McMaster-Rocketry-Team/OZYS_V3/firmware/README.md

# OZYS V3 Firmware

There is no bootloader. The firmware links at the reset vector and is flashed
directly, so nothing needs to be on the board beforehand.

## Memory Layout

The memory layout is defined in `memory.x`.

- Flash: 480KiB used of 512KiB, from `0x08000000`
- RAM: 128KiB

## Notes

- Flash firmware: `cargo run`
- Check firmware size: `python size.py`

`dev` profile and `release` profile are the same, so its fine to use the run button for final production firmware.

## rocket-cli

`rocket-cli` is a tool that simplifies uploading code and monitoring logs. Install it globally to the system by first cd into `<path-to-rust-monorepo>/rocket-cli` then run `cargo install --profile rocket-cli --path . --locked`

`rocket-cli` uses ST-Link or bluetooth for uploading depending on if an ST-Link is connected.

## Troubleshooting

If you think your code should run but the stm does not start or stops in the middle of execution:

1. Switch back from `rocket-cli` to `probe-rs` in `.cargo/config.toml`
2. Do not connect to ST-Link, instead use an external power
3. Power cycle the stm
