McMaster-Rocketry-Team/OZYS_V3/ozyz_v3/Graphics/bnw-text.png

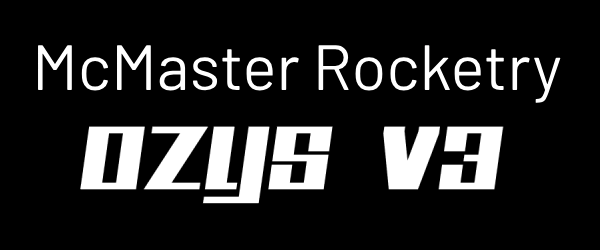
ozyz_v3/Graphics/bnw-text.png
