McMaster-Rocketry-Team/OZYS_V3/ozyz_v3/Graphics/BNW.png

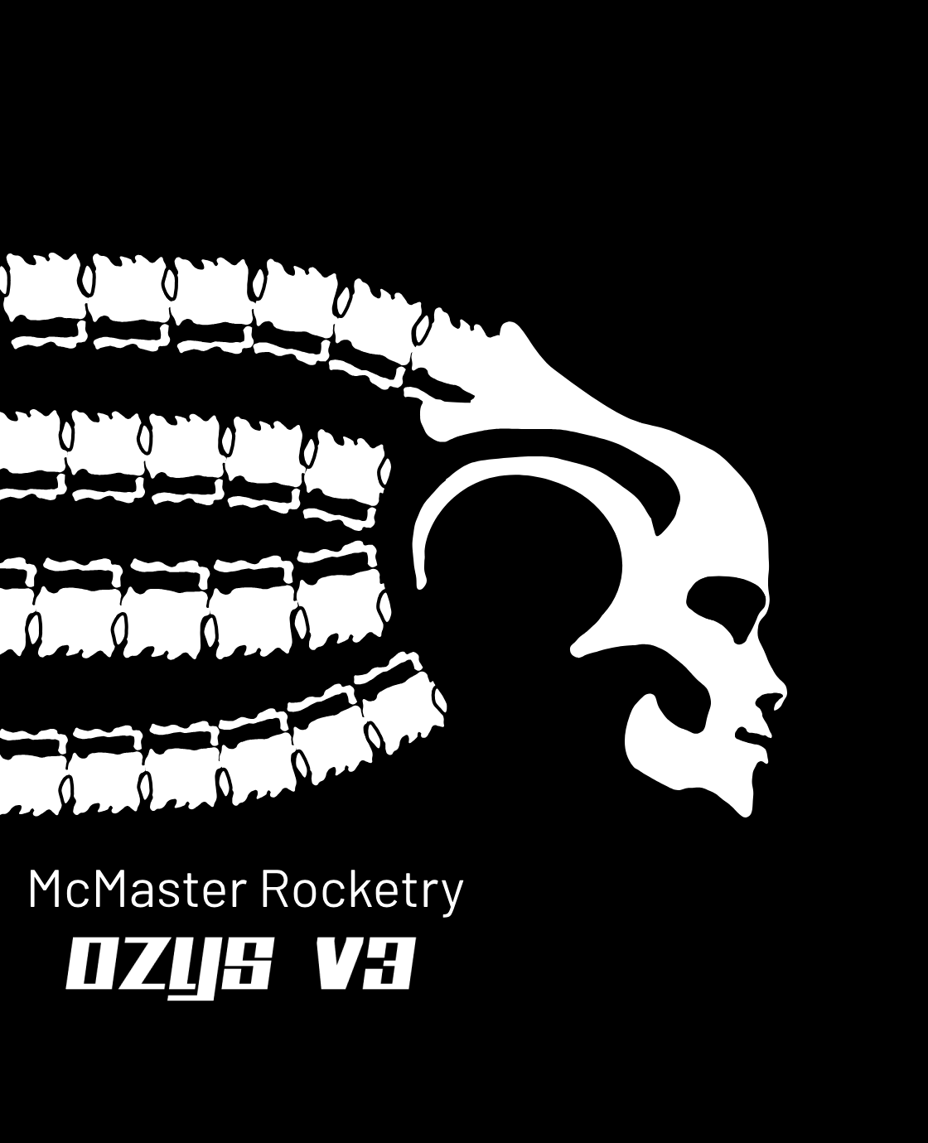
ozyz_v3/Graphics/BNW.png
