McMaster-Rocketry-Team/OZYS_V3/epsilon_r1/Epsilon_final.kicad_pcb

## KiCad design epsilon_r1/Epsilon_final.kicad_pcb (2025-02-16)

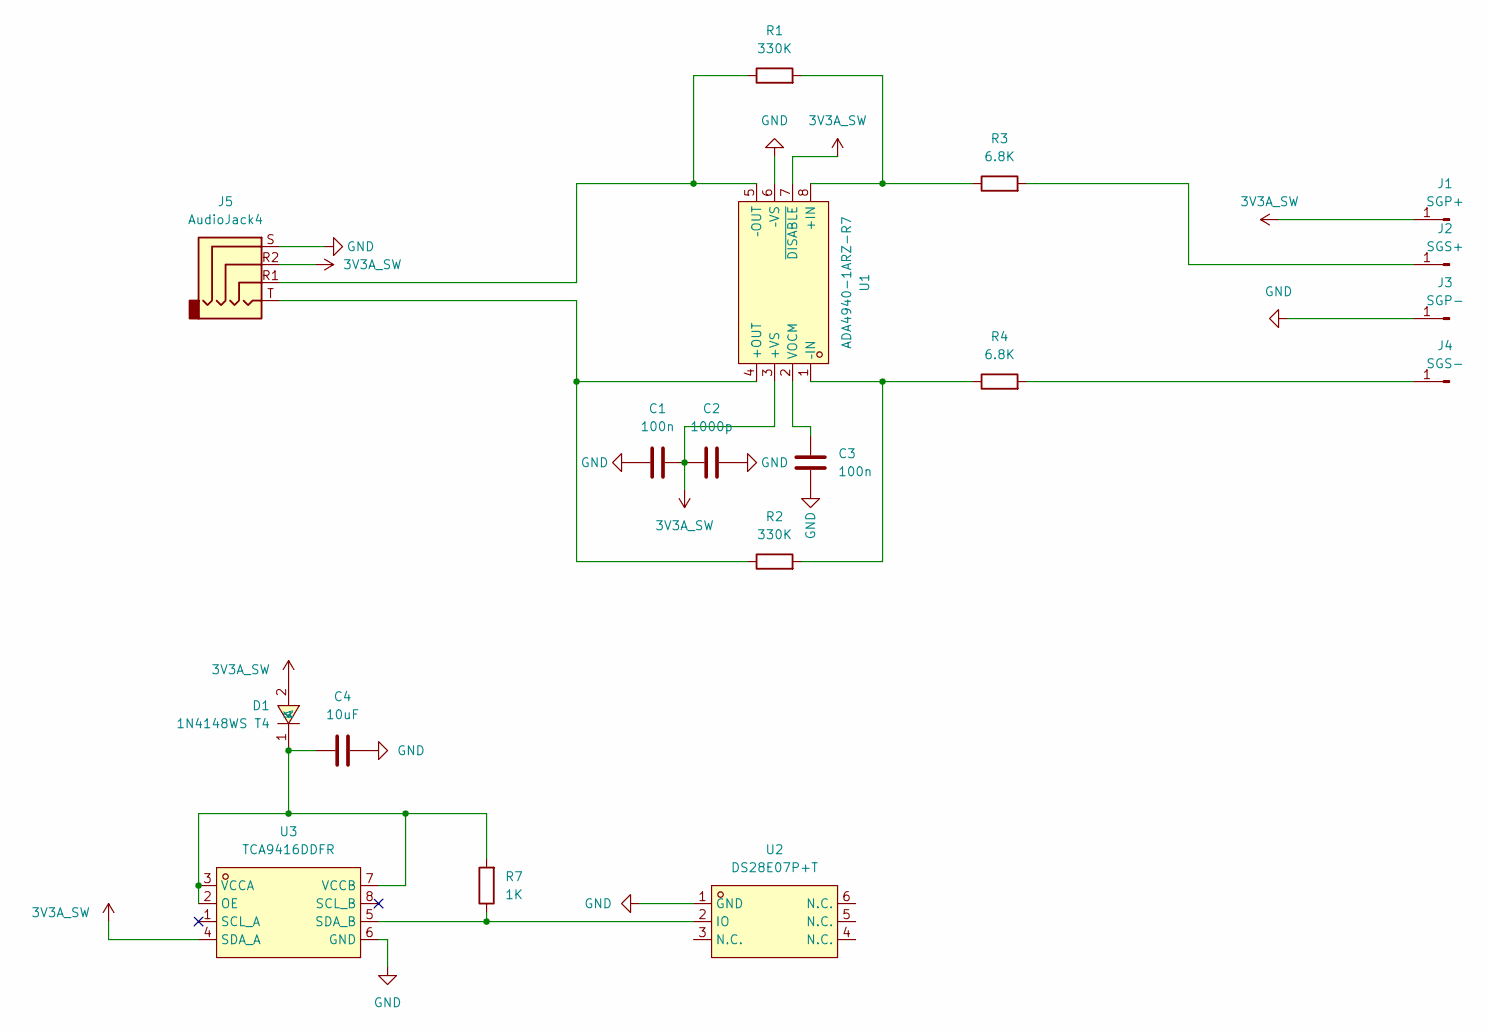
[picture p5: schematic Epsilon_final.kicad_sch]

Parts:
C1, C3: 100n; C_0402_1005Metric
C2: 1000p; C_0402_1005Metric
C4: 10uF; C_0402_1005Metric
D1: 1N4148WS T4; SOD-323_L1.8-W1.3-LS2.5-RD; LCSC Part C2128
J1: SGP+; SolderWirePad_1x01_SMD_1x2mm
J2: SGS+; SolderWirePad_1x01_SMD_1x2mm
J3: SGP-; SolderWirePad_1x01_SMD_1x2mm
J4: SGS-; SolderWirePad_1x01_SMD_1x2mm
J5: AudioJack4; AUDIO-TH_PJ-320A-4P-DIP
R1, R2: 330K; R_0603_1608Metric_Pad0.98x0.95mm_HandSolder
R3, R4: 6.8K; R_0603_1608Metric_Pad0.98x0.95mm_HandSolder
R7: 1K; R_0402_1005Metric
U1: ADA4940-1ARZ-R7; LFCSP-16_L3.0-W3.0-P0.50-BL-EP1.3; LCSC Part C730049
U2: DS28E07P+T; TSOC-6_L3.9-W4.3-P1.27-BL; LCSC Part C2063921
U3: TCA9416DDFR; TSOT-23-8_L2.9-W1.6-P0.65-LS2.8-BR; LCSC Part C4364143

Connections:
3V3A_SW: C1.1, C2.2, D1.2 (A), J1.1, J5.R2, U1.3 (+VS), U1.7 (~DISABLE), U3.4 (SDA_A)
GND: C1.2, C2.1, C3.1, C4.2, J3.1, J5.S, U1.6 (–VS), U2.1 (GND), U3.6 (GND)
unnamed: C4.1, D1.1 (K), R7.2, U3.2 (OE), U3.3 (VCCA), U3.7 (VCCB)
unnamed: J2.1, R3.2
unnamed: J4.1, R4.2
unnamed: R1.2, R3.1, U1.8 (+IN)
unnamed: J5.T, R2.1, U1.4 (+OUT)
unnamed: C3.2, U1.2 (VOCM)
unnamed: R2.2, R4.1, U1.1 (–IN)
unnamed: J5.R1, R1.1, U1.5 (–OUT)
unnamed: R7.1, U2.2 (IO), U3.5 (SDA_B)

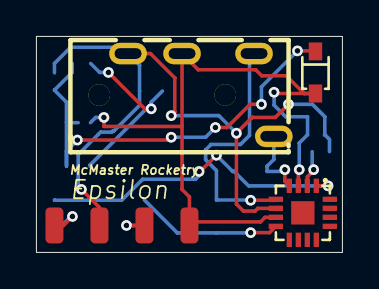
[picture p6: board Epsilon_final.kicad_pcb from above]

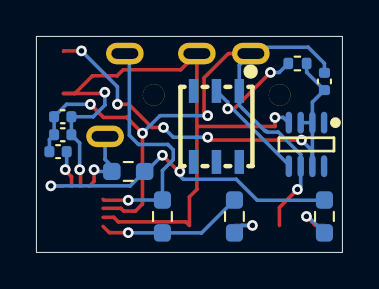
[picture p7: board Epsilon_final.kicad_pcb from below]

Board: 2 copper layers, 17.0 x 12.0 mm, 18 parts (11 on the bottom side), 11 nets.
