McMaster-Rocketry-Team/OZYS_V3/ozyz_v3/OZYS_V3_Final.kicad_pcb

## KiCad design ozyz_v3/OZYS_V3_Final.kicad_pcb (2025-03-06)

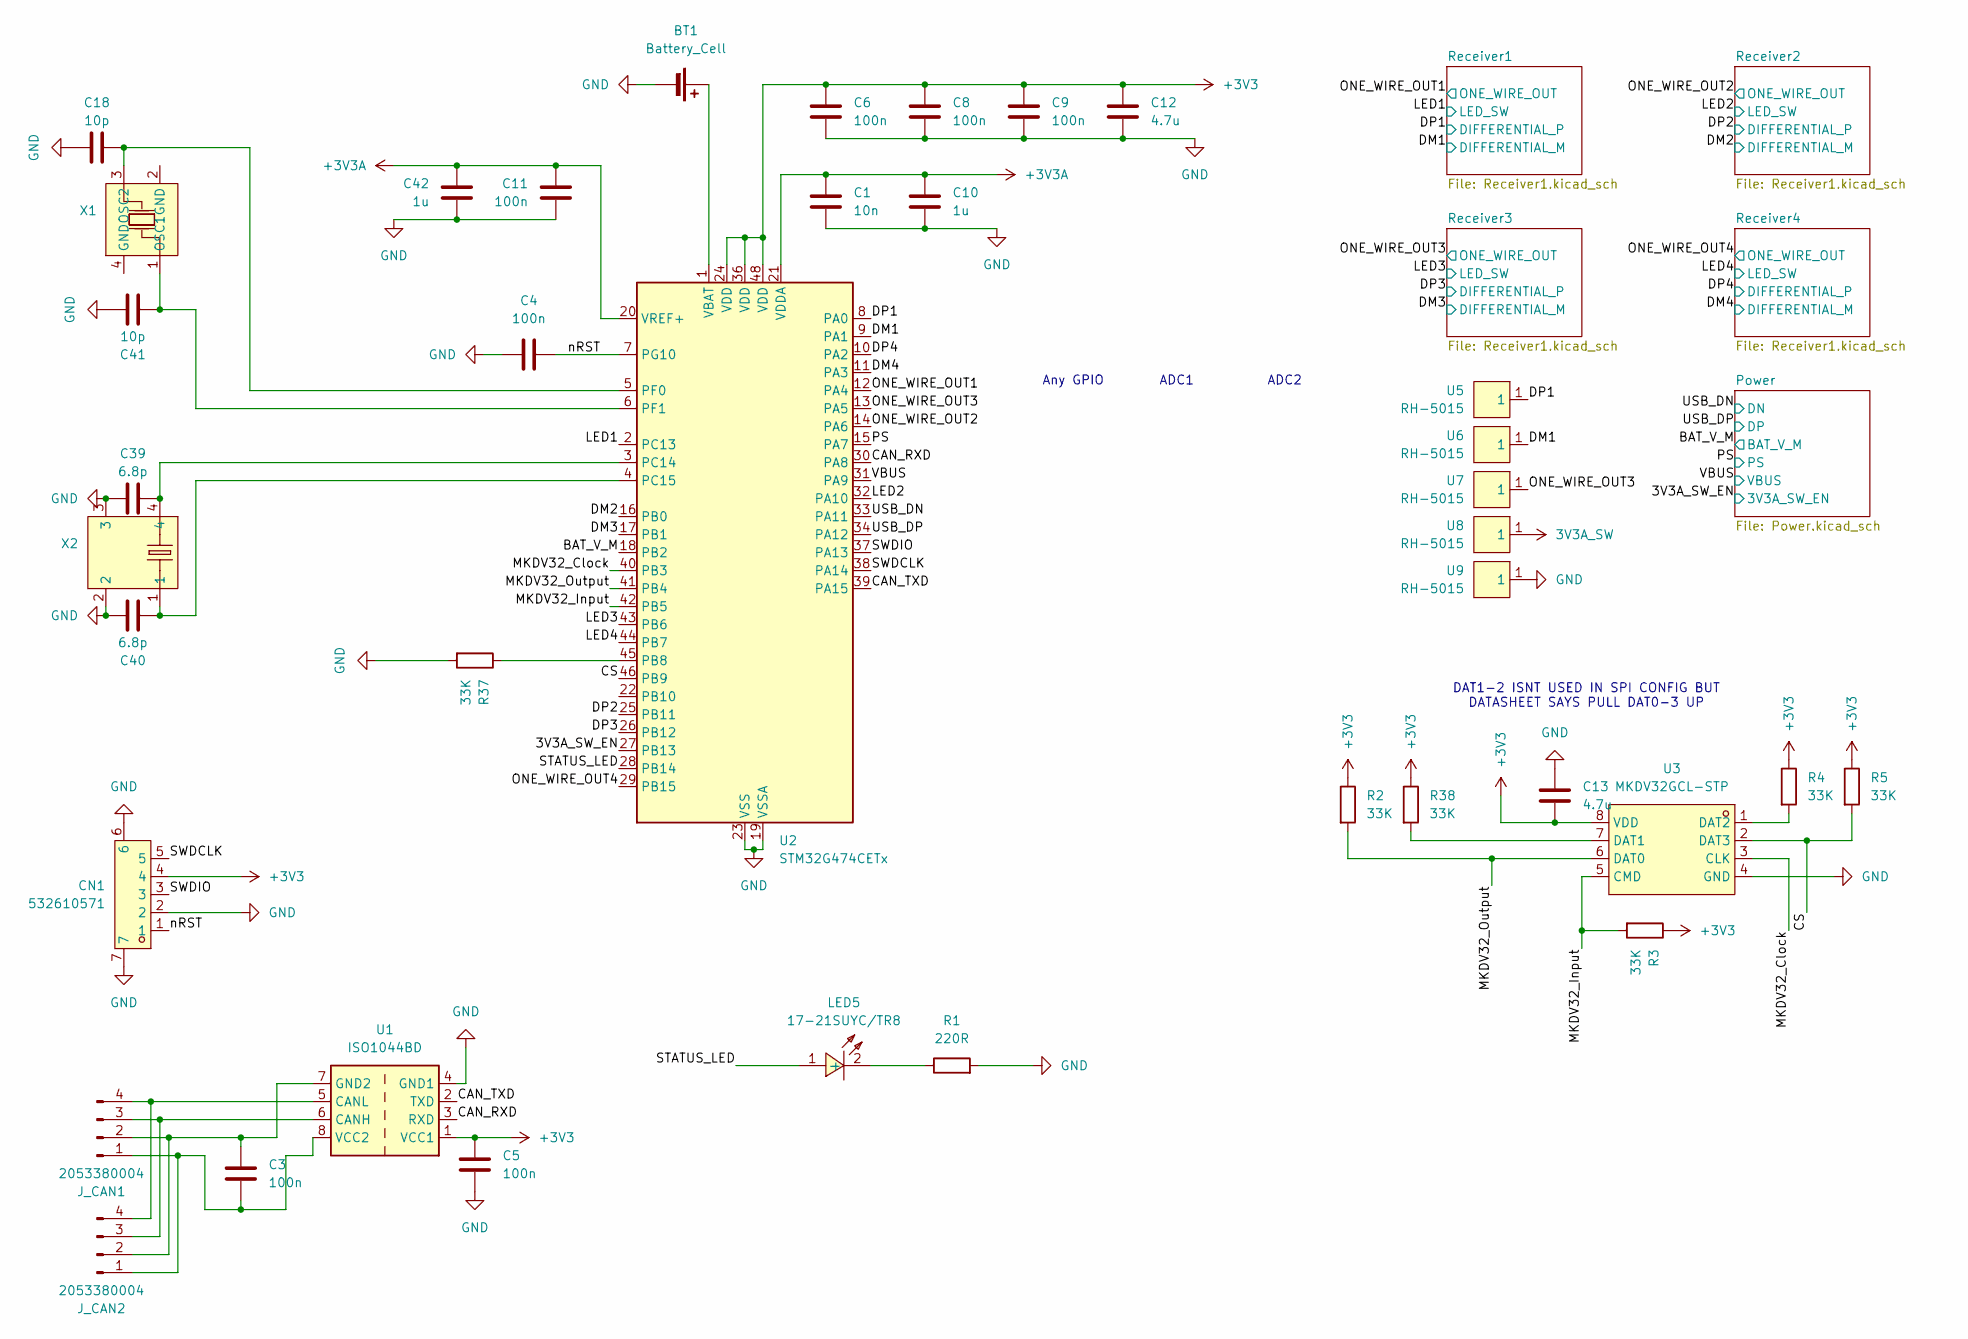
[picture p8: schematic OZYS_V3_Final.kicad_sch]

Parts:
BT1: Battery_Cell; SEIKO_ML414H_IV01E
C1: 10n; C_0402_1005Metric
C3, C4, C5, C6, C8, C9, C11: 100n; C_0402_1005Metric
C10, C42: 1u; C_0402_1005Metric
C12, C13: 4.7u; C_0402_1005Metric
C18, C41: 10p; C_0603_1608Metric_Pad1.08x0.95mm_HandSolder
C39, C40: 6.8p; C_0603_1608Metric_Pad1.08x0.95mm_HandSolder
CN1: 532610571; CONN-SMD_5P-P1.25_532610571-2; LCSC Part C392176
J_CAN1, J_CAN2: 2053380004; CONN_2053380000-SD_04_MOL
LED5: 17-21SUYC/TR8; LED0805-R-RD; LCSC Part C2296
R1: 220R; R_0402_1005Metric
R2, R3, R4, R5, R37, R38: 33K; R_0402_1005Metric
U1: ISO1044BD; SOIC-8_3.9x4.9mm_P1.27mm
U2: STM32G474CETx; LQFP-48_7x7mm_P0.5mm
U3: MKDV32GCL-STP; LGA-8_L6.0-W8.0-P1.27-TL; LCSC Part C7500179
U5, U6, U7, U8, U9: RH-5015; SMD_RH-5015; LCSC Part C5199798
X1: X322516MLB4SI; OSC-SMD_4P-L3.2-W2.5-BL; LCSC Part C13738
X2: MC-306 32.768kHz 6.0pF 20ppm; MC-306_4P-L8.0-W3.2-P5.5-BL; LCSC Part C83979

Connections:
3V3A_SW: U8.1; also elsewhere on the board
+3V3: C5.2, C6.1, C8.1, C9.1, C12.1, C13.2, CN1.4, R2.1, R3.1, R4.1, R5.1, R38.1, U1.1 (VCC1), U2.24 (VDD), U2.36 (VDD), U2.48 (VDD), U3.8 (VDD); also elsewhere on the board
+3V3A: C1.1, C10.2, C11.1, C42.2, U2.20 (VREF+), U2.21 (VDDA); also elsewhere on the board
/3V3A_SW_EN: U2.27 (PB13); also elsewhere on the board
/BAT_V_M: U2.18 (PB2); also elsewhere on the board
/CAN_RXD: U1.3 (RXD), U2.30 (PA8)
/CAN_TXD: U1.2 (TXD), U2.39 (PA15)
/CS: R5.2, U2.46 (PB9), U3.2 (DAT3)
/DM1: U2.9 (PA1), U6.1; also elsewhere on the board
/DM2: U2.16 (PB0); also elsewhere on the board
/DM3: U2.17 (PB1); also elsewhere on the board
/DM4: U2.11 (PA3); also elsewhere on the board
/DP1: U2.8 (PA0), U5.1; also elsewhere on the board
/DP2: U2.25 (PB11); also elsewhere on the board
/DP3: U2.26 (PB12); also elsewhere on the board
/DP4: U2.10 (PA2); also elsewhere on the board
/LED1: U2.2 (PC13); also elsewhere on the board
/LED2: U2.32 (PA10); also elsewhere on the board
/LED3: U2.43 (PB6); also elsewhere on the board
/LED4: U2.44 (PB7); also elsewhere on the board
/MKDV32_Clock: U2.40 (PB3), U3.3 (CLK)
/MKDV32_Input: R3.2, U2.42 (PB5), U3.5 (CMD)
/MKDV32_Output: R2.2, U2.41 (PB4), U3.6 (DAT0)
/ONE_WIRE_OUT1: U2.12 (PA4); also elsewhere on the board
/ONE_WIRE_OUT2: U2.14 (PA6); also elsewhere on the board
/ONE_WIRE_OUT3: U2.13 (PA5), U7.1; also elsewhere on the board
/ONE_WIRE_OUT4: U2.29 (PB15); also elsewhere on the board
/PS: U2.15 (PA7); also elsewhere on the board
/STATUS_LED: LED5.1 (+), U2.28 (PB14)
/SWDCLK: CN1.5, U2.38 (PA14)
/SWDIO: CN1.3, U2.37 (PA13)
/USB_DN: U2.33 (PA11); also elsewhere on the board
/USB_DP: U2.34 (PA12); also elsewhere on the board
/VBUS: U2.31 (PA9); also elsewhere on the board
/nRST: C4.2, CN1.1, U2.7 (PG10)
GND: BT1.2 (-), C1.2, C4.1, C5.1, C6.2, C8.2, C9.2, C10.1, C11.2, C12.2, C13.1, C18.1, C39.1, C40.2, C41.1, C42.1, CN1.2, CN1.6, CN1.7, R1.2, R37.2, U1.4 (GND1), U2.19 (VSSA), U2.23 (VSS), U2.35 (VSS), U2.47 (VSS), U3.4 (GND), U9.1, X2.2, X2.3; also elsewhere on the board
unnamed: BT1.1 (+), U2.1 (VBAT)
unnamed: C3.2, J_CAN1.1, J_CAN2.1, U1.8 (VCC2)
unnamed: C3.1, J_CAN1.2, J_CAN2.2, U1.7 (GND2)
unnamed: J_CAN1.3, J_CAN2.3, U1.6 (CANH)
unnamed: J_CAN1.4, J_CAN2.4, U1.5 (CANL)
unnamed: LED5.2 (-), R1.1
unnamed: R37.1, U2.45 (PB8)
unnamed: C39.2, U2.3 (PC14), X2.4
unnamed: C40.1, U2.4 (PC15), X2.1
unnamed: C18.2, U2.5 (PF0), X1.3 (OSC2)
unnamed: C41.2, U2.6 (PF1), X1.1 (OSC1)
unnamed: R38.2, U3.7 (DAT1)
unnamed: R4.2, U3.1 (DAT2)

Notes on the sheet:
ADC1
ADC2
DAT1-2 ISNT USED IN SPI CONFIG BUT DATASHEET SAYS PULL DAT0-3 UP
Any GPIO

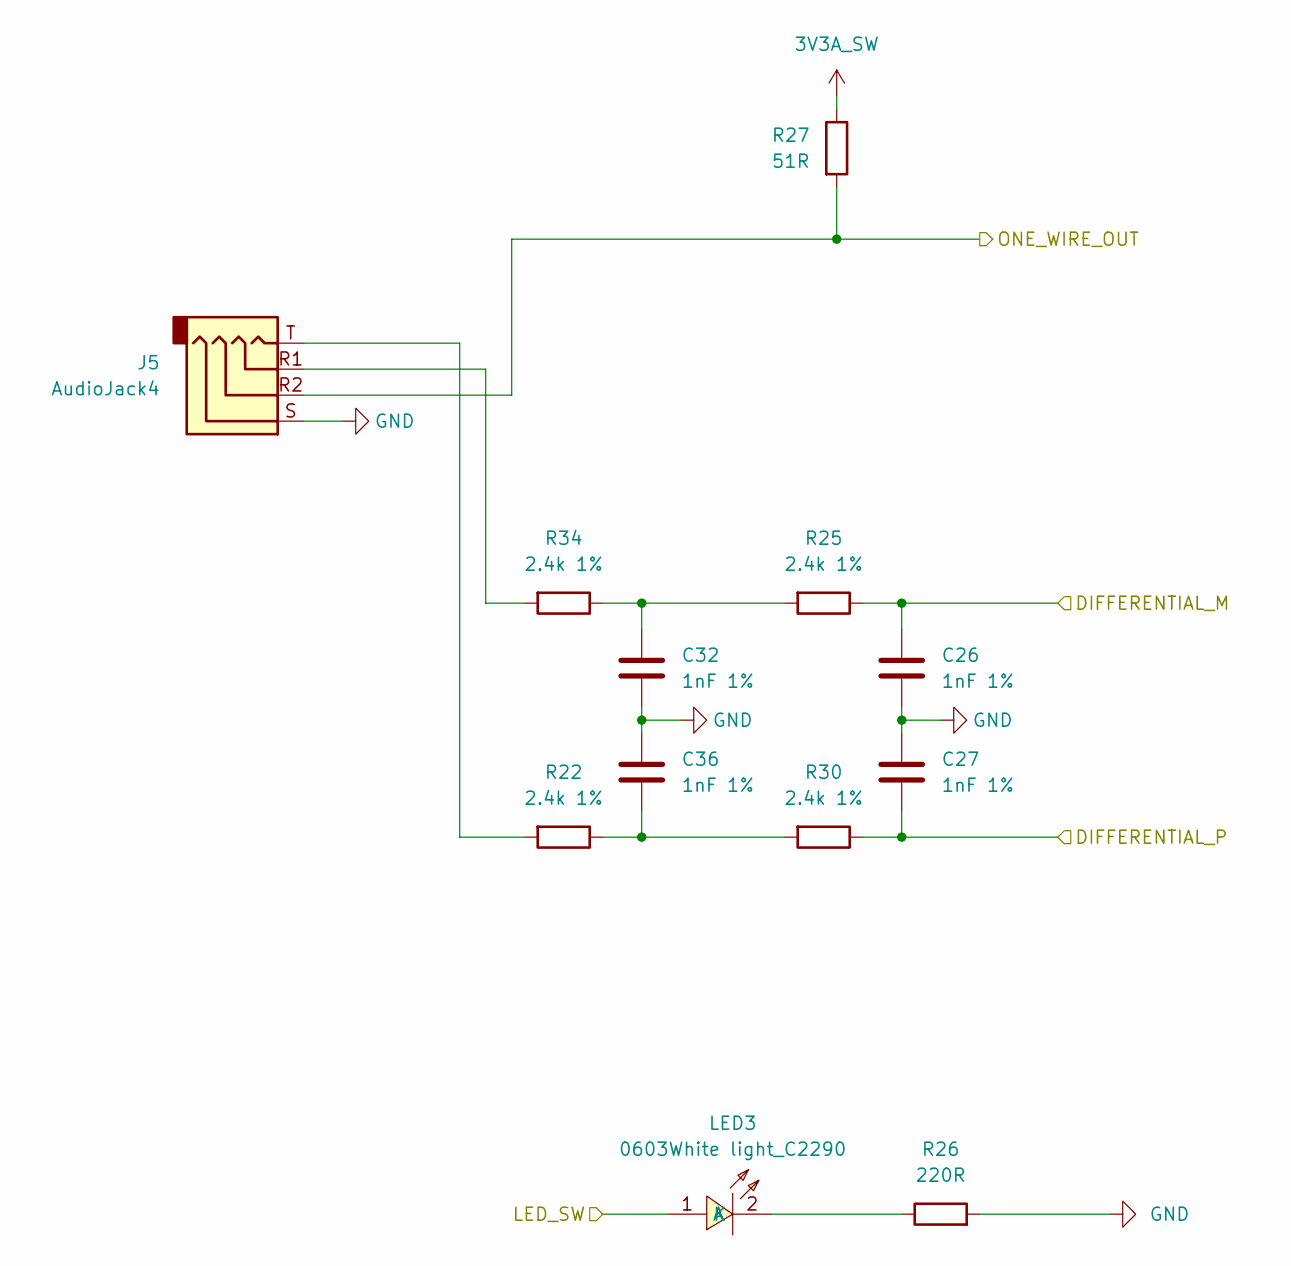
[picture p9: schematic Receiver1.kicad_sch]

Parts:
C26, C27, C32, C36: 1nF 1%; C_0603_1608Metric_Pad1.08x0.95mm_HandSolder
J5: AudioJack4; AUDIO-TH_PJ-320A-4P-DIP
LED3: 0603White light_C2290; LED0603-R-RD_WHITE; LCSC Part C2290
R22, R25, R30, R34: 2.4k 1%; C_0603_1608Metric_Pad1.08x0.95mm_HandSolder
R26: 220R; R_0402_1005Metric
R27: 51R; R_0402_1005Metric

Connections:
3V3A_SW: R27.1; also elsewhere on the board
/DM3: C26.1, R25.1; also elsewhere on the board
/DP3: C27.2, R30.1; also elsewhere on the board
/LED3: LED3.1 (A); also elsewhere on the board
/ONE_WIRE_OUT3: J5.R2, R27.2; also elsewhere on the board
GND: C26.2, C27.1, C32.2, C36.1, J5.S, R26.2; also elsewhere on the board
unnamed: C32.1, R25.2, R34.1
unnamed: C36.2, R22.1, R30.2
unnamed: J5.R1, R34.2
unnamed: J5.T, R22.2
unnamed: LED3.2 (K), R26.1

Parts of its further copies:
C2, C7, C22, C24, C28, C29, C30, C31, C33, C34, C35, C37: 1nF 1%; C_0603_1608Metric_Pad1.08x0.95mm_HandSolder
J3, J4, J6: AudioJack4; AUDIO-TH_PJ-320A-4P-DIP
LED1, LED2, LED4: 0603White light_C2290; LED0603-R-RD_WHITE; LCSC Part C2290
R13, R14, R19, R20, R21, R23, R24, R28, R29, R31, R35, R36: 2.4k 1%; C_0603_1608Metric_Pad1.08x0.95mm_HandSolder
R15, R17, R32: 220R; R_0402_1005Metric
R16, R18, R33: 51R; R_0402_1005Metric

Connections of its further copies:
3V3A_SW: R16.1, R18.1, R33.1; also elsewhere on the board
/DM1: C2.1, R13.1; also elsewhere on the board
/DM2: C22.1, R21.1; also elsewhere on the board
/DM4: C28.1, R31.1; also elsewhere on the board
/DP1: C7.2, R14.1; also elsewhere on the board
/DP2: C24.2, R24.1; also elsewhere on the board
/DP4: C29.2, R36.1; also elsewhere on the board
/LED1: LED2.1 (A); also elsewhere on the board
/LED2: LED1.1 (A); also elsewhere on the board
/LED4: LED4.1 (A); also elsewhere on the board
/ONE_WIRE_OUT1: J3.R2, R16.2; also elsewhere on the board
/ONE_WIRE_OUT2: J4.R2, R18.2; also elsewhere on the board
/ONE_WIRE_OUT4: J6.R2, R33.2; also elsewhere on the board
GND: C2.2, C7.1, C22.2, C24.1, C28.2, C29.1, C30.2, C31.2, C33.2, C34.1, C35.1, C37.1, J3.S, J4.S, J6.S, R15.2, R17.2, R32.2; also elsewhere on the board
unnamed: C30.1, R13.2, R28.1
unnamed: C31.1, R21.2, R29.1
unnamed: C33.1, R31.2, R35.1
unnamed: C34.2, R14.2, R19.1
unnamed: C35.2, R20.1, R24.2
unnamed: C37.2, R23.1, R36.2
unnamed: J3.R1, R28.2
unnamed: J3.T, R19.2
unnamed: J4.R1, R29.2
unnamed: J4.T, R20.2
unnamed: J6.R1, R35.2
unnamed: J6.T, R23.2
unnamed: LED1.2 (K), R17.1
unnamed: LED2.2 (K), R15.1
unnamed: LED4.2 (K), R32.1

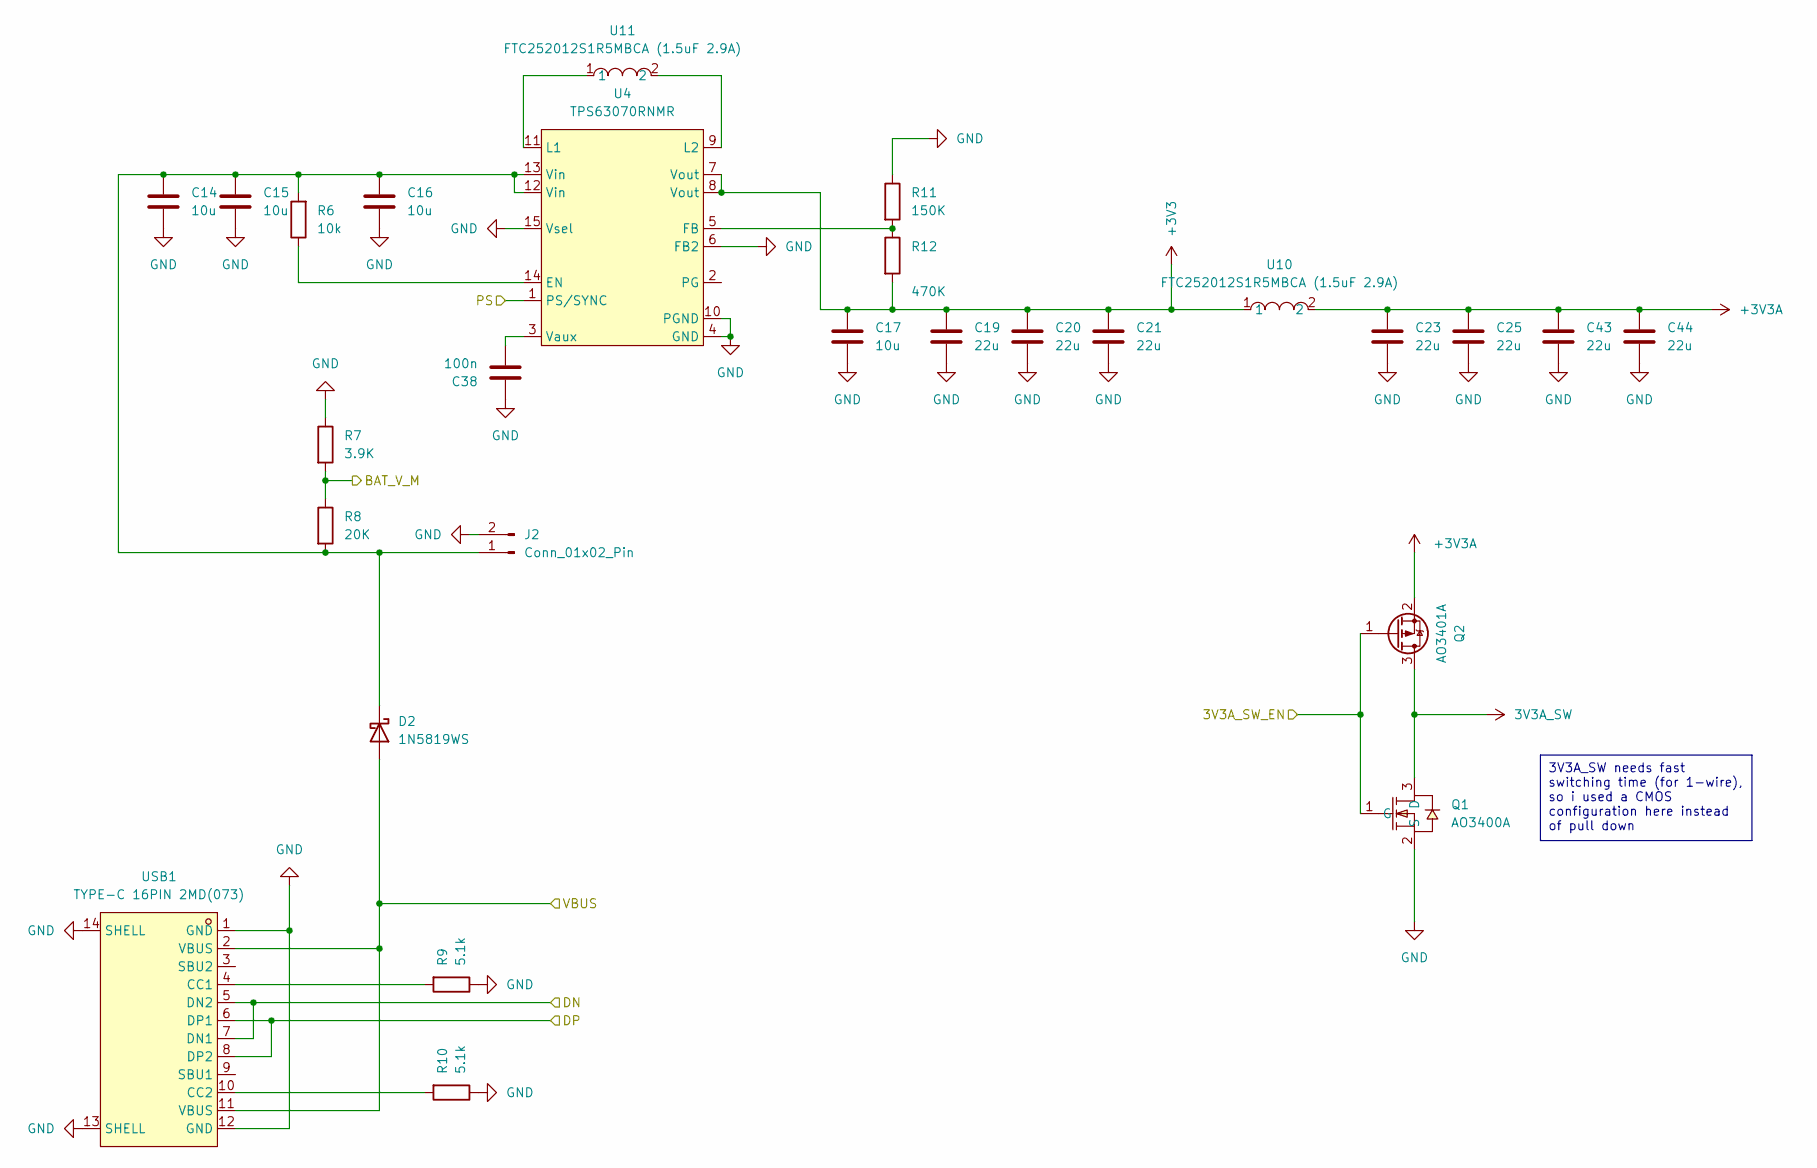
[picture p10: schematic Power.kicad_sch]

Parts:
C14, C15, C16, C17: 10u; C_0603_1608Metric
C19, C20, C21, C23, C25, C43, C44: 22u; C_0603_1608Metric
C38: 100n; C_0402_1005Metric
D2: 1N5819WS; D_SOD-323
J2: Conn_01x02_Pin; 1054301102
Q1: AO3400A; SOT-23-3_L2.9-W1.3-P1.90-LS2.4-BR; LCSC Part C20917
Q2: AO3401A; SOT-23
R6: 10k; R_0402_1005Metric
R7: 3.9K; R_0402_1005Metric
R8: 20K; R_0402_1005Metric
R9, R10: 5.1k; R_0402_1005Metric
R11: 150K; R_0402_1005Metric
R12: 470K; R_0402_1005Metric
U4: TPS63070RNMR; VQFN-HR-15_L3.0-W2.5-P0.50-BL_TPS63070RNMR; LCSC Part C109322
U10, U11: FTC252012S1R5MBCA (1.5uF 2.9A); IND-SMD_L2.5-W2.0_MEKK2520TR47M; LCSC Part C5832371
USB1: TYPE-C 16PIN 2MD(073); USB-C-SMD_TYPE-C-6PIN-2MD-073; LCSC Part C2765186

Connections:
3V3A_SW: Q1.3 (D), Q2.3 (D); also elsewhere on the board
+3V3: C17.2, C19.2, C20.2, C21.2, R12.2, U4.7 (Vout), U4.8 (Vout), U10.1; also elsewhere on the board
+3V3A: C23.2, C25.2, C43.2, C44.2, Q2.2 (S), U10.2; also elsewhere on the board
/3V3A_SW_EN: Q1.1 (G), Q2.1 (G); also elsewhere on the board
/BAT_V_M: R7.2, R8.1; also elsewhere on the board
/PS: U4.1 (PS/SYNC); also elsewhere on the board
/USB_DN: USB1.5 (DN2), USB1.7 (DN1); also elsewhere on the board
/USB_DP: USB1.6 (DP1), USB1.8 (DP2); also elsewhere on the board
/VBUS: D2.2 (A), USB1.2 (VBUS), USB1.11 (VBUS); also elsewhere on the board
GND: C14.1, C15.1, C16.1, C17.1, C19.1, C20.1, C21.1, C23.1, C25.1, C38.2, C43.1, C44.1, J2.2, Q1.2 (S), R7.1, R9.1, R10.1, R11.1, U4.4 (GND), U4.6 (FB2), U4.10 (PGND), U4.15 (Vsel), USB1.1 (GND), USB1.12 (GND), USB1.13 (SHELL), USB1.14 (SHELL); also elsewhere on the board
unnamed: C14.2, C15.2, C16.2, D2.1 (K), J2.1, R6.2, R8.2, U4.12 (Vin), U4.13 (Vin)
unnamed: R6.1, U4.14 (EN)
unnamed: R11.2, R12.1, U4.5 (FB)
unnamed: U4.11 (L1), U11.1
unnamed: U4.9 (L2), U11.2
unnamed: C38.1, U4.3 (Vaux)
unnamed: R9.2, USB1.4 (CC1)
unnamed: R10.2, USB1.10 (CC2)

Notes on the sheet:
3V3A_SW needs fast switching time (for 1-wire), so i used a CMOS configuration here instead of pull down

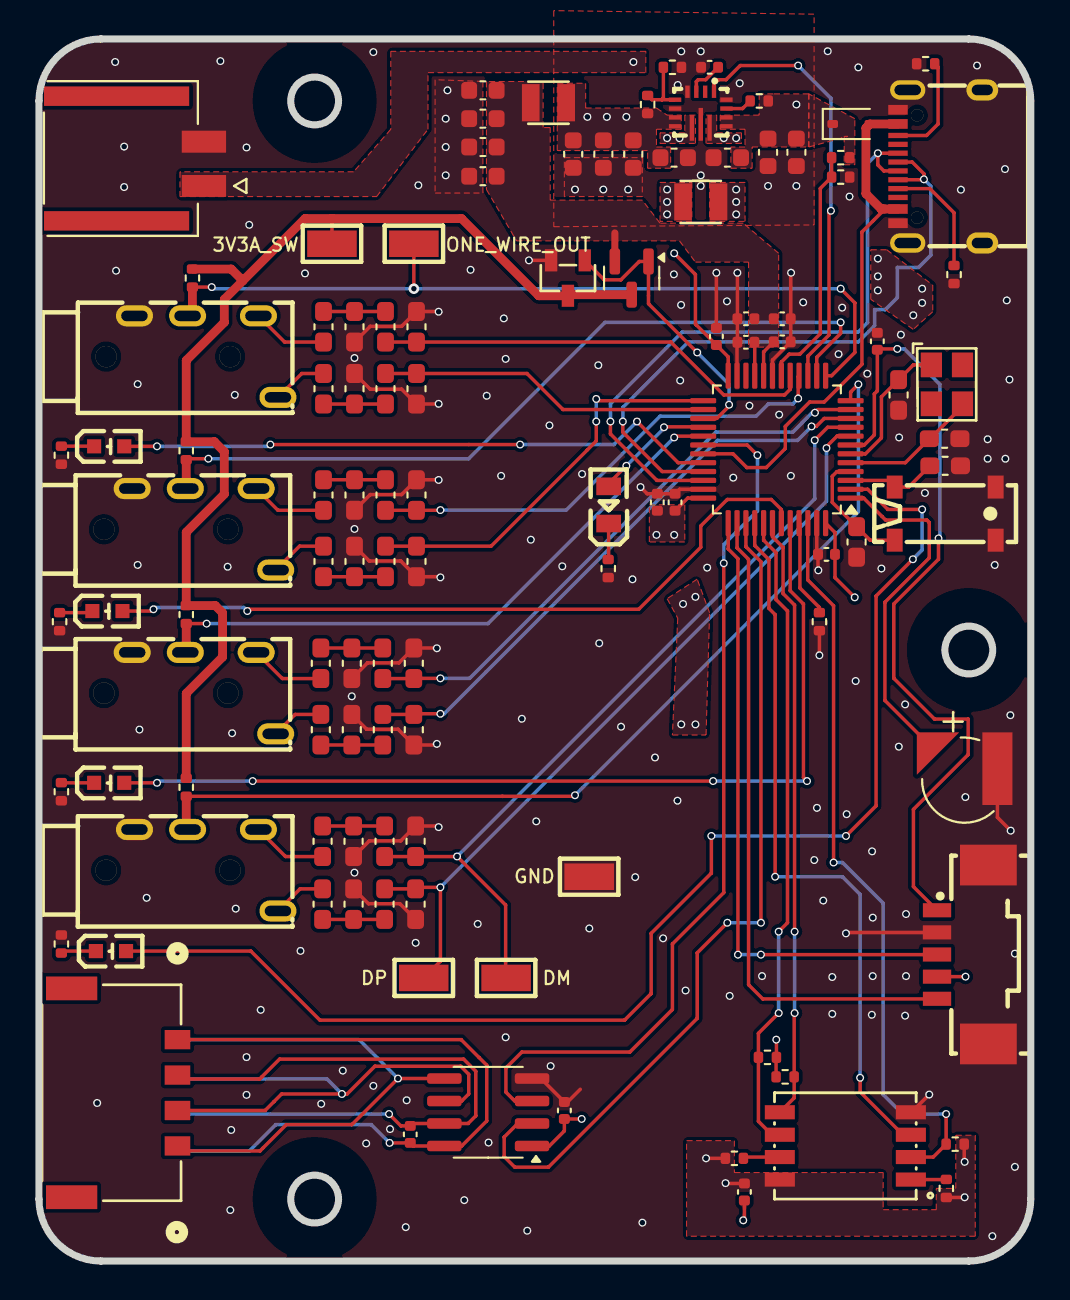
[picture p11: board OZYS_V3_Final.kicad_pcb from above]

Board: 4 copper layers, 56.0 x 69.0 mm, 113 parts (1 on the bottom side), 77 nets.
