McMaster-Rocketry-Team/OZYS_V3/CubeMX/ozys.ioc

Mcu.UserName=STM32G474CETx
PA0.Signal=ADC1_IN1
PA1.Signal=ADC1_IN2
PA11.Signal=USB_DM
PA12.Signal=USB_DP
PA13.Signal=SYS_JTMS-SWDIO
PA14.Signal=SYS_JTCK-SWCLK
PA15.Signal=FDCAN3_TX
PA2.Signal=ADC1_IN3
PA3.Signal=ADC1_IN4
PA4.Signal=ADC2_IN17
PA5.Signal=ADC2_IN13
PA6.Signal=ADC2_IN3
PA8.Signal=FDCAN3_RX
PB0.Signal=ADC1_IN15
PB1.Signal=ADC1_IN12
PB11.Signal=ADC1_IN14
PB12.Signal=ADC1_IN11
PB15.Signal=ADC2_IN15
PB2.Signal=ADC2_IN12
PB3.Signal=SPI1_SCK
PB4.Signal=SPI1_MISO
PB5.Signal=SPI1_MOSI
PC14-OSC32_IN.Signal=RCC_OSC32_IN
PC15-OSC32_OUT.Signal=RCC_OSC32_OUT
PF0-OSC_IN.Signal=RCC_OSC_IN
PF1-OSC_OUT.Signal=RCC_OSC_OUT
