McMaster-Rocketry-Team/OZYS_V3/(commit log)

2024-11-11 Modified transconductance stages
2024-11-17 Updated Receiver, Driver, and Strain Gauges.
    ~200x gain for driver
2024-11-18 change diff line driver model
2024-11-29 Init Repo and uploading schematics
    [Epsilon.kicad_sch, Ozys.kicad_sch, Power.kicad_sch, Receiver_1.kicad_sch, SG_PCB_V3_1.kicad_pcb, SG_PCB_V3_1.kicad_sch]
2024-11-29 renames and cleanup
    [Epsilon.kicad_sch, Ozys.kicad_sch, Power.kicad_sch, Receiver_1.kicad_sch, SG_PCB_V3_1.kicad_pcb, SG_PCB_V3_1.kicad_sch]
2024-12-05 Started PCBs fixed connectors
    - Fixed Bypass on CAN
    - Seperated SG connectors from 2x1 to 1x1
    - Rough Draft of Epsilon
    [Epsilon.kicad_pcb, Epsilon.kicad_sch, Ozys.kicad_sch, Power.kicad_sch, Receiver_1.kicad_sch, SG_PCB_V3_1.kicad_sch]
2024-12-10 Updated Epsilon PCB and Ozys Sch
    [Epsilon.kicad_pcb, Epsilon.kicad_sch, Ozys.kicad_sch, Power.kicad_sch, Receiver_Extra.kicad_sch, Receiver_Main.kicad_sch, untitled.kicad_sch]
2025-02-02 Yolo
    Nothing could go wrong
    [EpsilonV1.kicad_pcb, EpsilonV2.kicad_pcb, EpsilonV3.kicad_pcb, Ozys.kicad_sch, Power.kicad_sch, Receiver_Extra.kicad_sch, Receiver_Main.kicad_sch]
2025-02-02 Yolo2
    new Ozys
    [Epsilon.kicad_pcb, Epsilon.kicad_sch, EpsilonV1.kicad_pcb, EpsilonV2.kicad_pcb, EpsilonV3.kicad_pcb, Epsilon_final.kicad_pcb, Epsilon_final.kicad_sch, OZYS_V3_Final.kicad_pcb]
2025-02-03 OZYS and EPSILON schematics updated.
    OZYS
    - New 3.5 PJ-320A-4P DIP
    - Fixed TPS Regulator Connections
    - Fixed STM32 Connections
    - Added Associated .ioc for stm32 pin config
    - Loading Capacitance of LSE based off an5093 STM datasheet
    EPSILON
    - same 3.5 as OZYS
    [Epsilon_final.kicad_sch, OZYS_V3_Final.kicad_sch, Power.kicad_sch, Receiver1.kicad_sch]
2025-02-07 epsilon ready for layout
    [Epsilon_final.kicad_pcb, Epsilon_final.kicad_sch, OZYS_V3_Final.kicad_pcb, OZYS_V3_Final.kicad_sch, Power.kicad_sch, Receiver.kicad_sch, Receiver1.kicad_sch, Receiver_Extra.kicad_sch]
2025-02-07 OZYS ready for layout
    [OZYS_V3_Final.kicad_pcb, OZYS_V3_Final.kicad_sch, Power.kicad_sch, Receiver1.kicad_sch]
2025-02-07 update connector placement
    [OZYS_V3_Final.kicad_pcb, OZYS_V3_Final.kicad_sch, Receiver1.kicad_sch]
2025-02-16 Epsilon PCB Finished
    Updated OZYS still WIP.
    [Epsilon_final.kicad_pcb, OZYS_V3_Final.kicad_pcb]
2025-02-16 add epsilon manufacturing files
    [Epsilon_final.kicad_pcb]
2025-02-28 Saving Rough Iteration of Ozys V3
    -STM Pins to be configured with current layout
    [OZYS_V3_Final.kicad_pcb, OZYS_V3_Final.kicad_sch]
2025-02-28 Saving another rough trace
    saving for iteration purposes
    [OZYS_V3_Final.kicad_pcb]
2025-02-28 Fixed LEDs
    - Just need to clean it up then add pours and GND vias
    [OZYS_V3_Final.kicad_pcb, OZYS_V3_Final.kicad_sch]
2025-02-28 fixed connections and playing with pours
    as summary describes
    [OZYS_V3_Final.kicad_pcb, OZYS_V3_Final.kicad_sch]
2025-03-01 Test Config
    Testing config :)
    [OZYS_V3_Final.kicad_pcb]
2025-03-01 Got rid of LED Fet
    - restructuring
    [OZYS_V3_Final.kicad_pcb, OZYS_V3_Final.kicad_sch, Receiver1.kicad_sch]
2025-03-01 Updated with Pours
    Only missing gnd pours on top and bottom copper planes
    [OZYS_V3_Final.kicad_pcb]
2025-03-02 small changes
    small changes
    [OZYS_V3_Final.kicad_pcb]
2025-03-02 Ozys finalized?
    Hopefully
    [OZYS_V3_Final.kicad_pcb]
2025-03-06 Pours fixed, no Graphics
    Made sure all pours conform to 8mils clearance and width, with Solid connections.
    [OZYS_V3_Final.kicad_pcb, Receiver1.kicad_sch]
2025-03-06 final touches
    [OZYS_V3_Final.kicad_pcb, OZYS_V3_Final.kicad_sch]
2025-03-06 Graphics Added on back
    Yipiee
    [OZYS_V3_Final.kicad_pcb]
2025-03-06 Updated edge alignment and text
    Yipeee
    [OZYS_V3_Final.kicad_pcb]
2025-05-02 adc test
2025-05-02 fix led
2025-05-25 Epsilon Symbol Fixed
    Epsilon Symbol Fixed
    [Epsilon_final.kicad_pcb, Epsilon_final.kicad_sch]
2025-07-11 add toggle pwm
2025-07-30 add pcb version to readme
2025-08-01 fix build; revert to probe-rs
    [main.rs]
2025-08-13 Write ADC to whole block test
2025-08-18 increased capacity and fixed leds
    [main.rs]
2025-08-18 reset sd card on can reset task
    [main.rs]
2026-08-16 rust analyzer fix and make it log while in flight too
    [main.rs]
2026-08-16 hardware-filter the CAN bus on the strain gauge node
    The flight computer broadcasts roughly a thousand measurement frames a
    second. Every one of them was raising an rx interrupt here and getting
    decoded, only to be dropped, while the strain gauge ADCs sample on a hard
    deadline. This node consumes VLStatus, Reset and UnixTime and nothing else.
    FDCAN needs both halves of the change. The extended filter matches what we
    want, and the global filter decides the fate of everything else -- its
    default is IntoRxFifo0, so installing the filter alone would have changed
    nothing at all. FDCAN's classic filter accepts a frame iff
    `incoming & mask == filter & mask`, which with filter = 0 is exactly the
    co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
    [can.rs]
2026-08-16 remove the bootloader and fix the firmware build
    The firmware has not compiled for some time: ResetMessage lost its
    into_bootloader field, so the reset handler failed to destructure it. The
    bootloader crate was further behind still -- it wanted a `bootloader`
    feature that firmware-common-new no longer has, and behind that the
    firmware_common_new::bootloader module, DataType::Firmware, and the
    Rust_Monorepo/bootloader key directory it embeds a public key from are all
    gone. The OTA subsystem it depends on no longer exists.
    Rather than resurrect it, drop it. memory.x already linked the firmware at
    the reset vector with the bootloader-offset layout commented out, so this
    matches how the board i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
    [adc_test.rs, can.rs, main.rs, size.py, watchdog.rs]
